jes/jpc1000/README.md

# JPC-1000

This is a repo containing Arduino code, KiCad files for PCBs, and FreeCAD files for the 3d-printed case.

Read more about the project on my blog: https://incoherency.co.uk/blog/stories/process-controller.html
