jes/jpc1000/case/mainboardholderclamp.obj

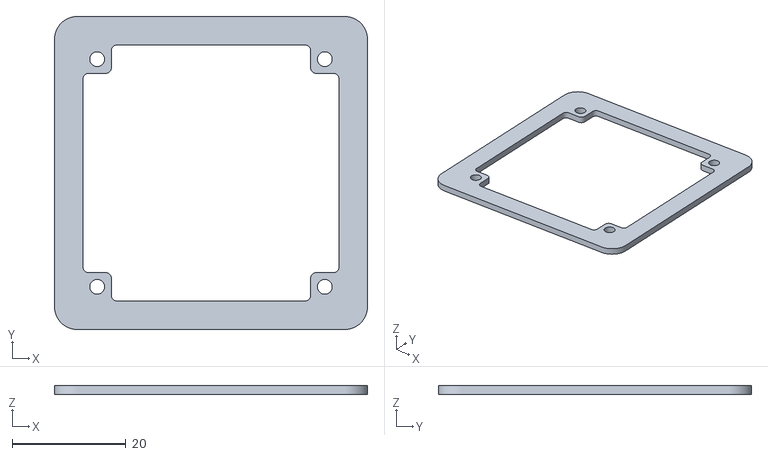
[picture p1: CAD file, 2019-08-26]
case/mainboardholderclamp.obj
55.0 x 55.0 x 1.50
