jes/jpc1000/case/mainboardholder.obj

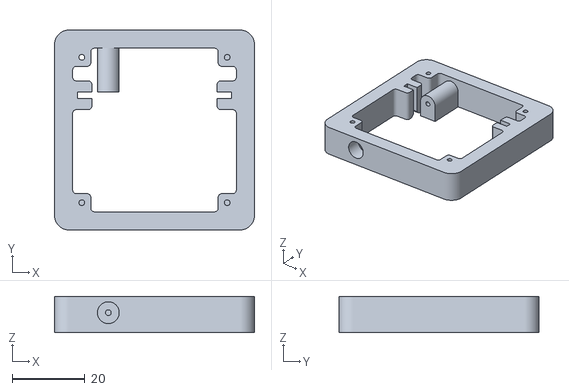
[picture p2: CAD file, 2019-08-26]
case/mainboardholder.obj
55.0 x 55.0 x 10.0
