jes/jpc1000/case/buttons.obj

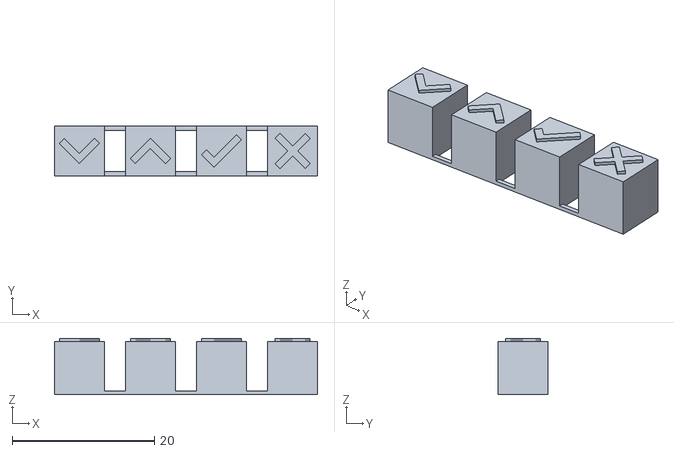
[picture p3: CAD file, 2019-09-01]
case/buttons.obj
37.0 x 7.00 x 7.90
