jes/jpc1000/case/frontcase.obj

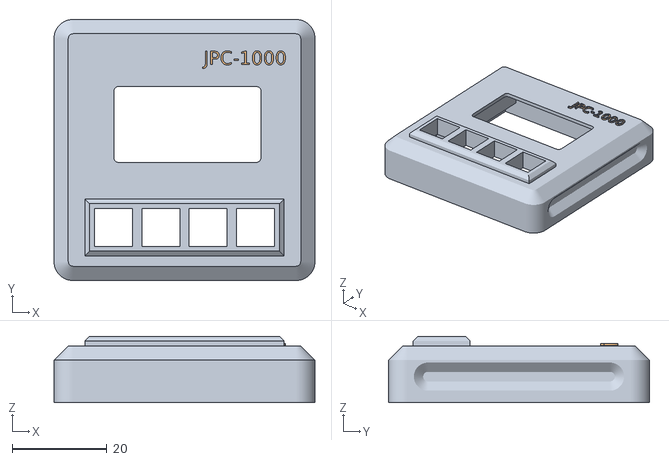
[picture p4: CAD file, 2019-09-01]
case/frontcase.obj
55.0 x 55.0 x 14.0
frontcase
