jes/jpc1000/case/jpc1000.fcstd

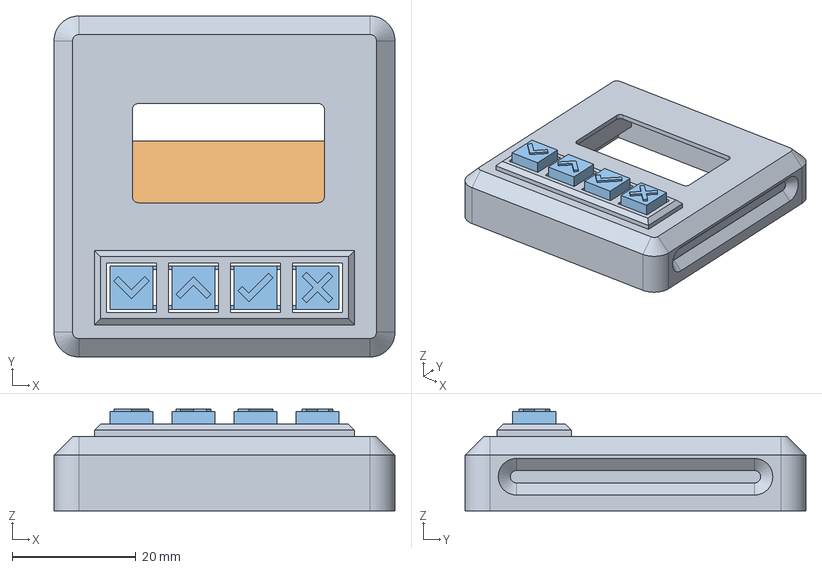
[picture p5: CAD file, 2019-09-01]
case/jpc1000.fcstd
55.0 x 55.0 x 16.4 mm
frontcase
frontpanelclamp
buttons
