jes/jpc1000/case/frontpanelclamp.obj

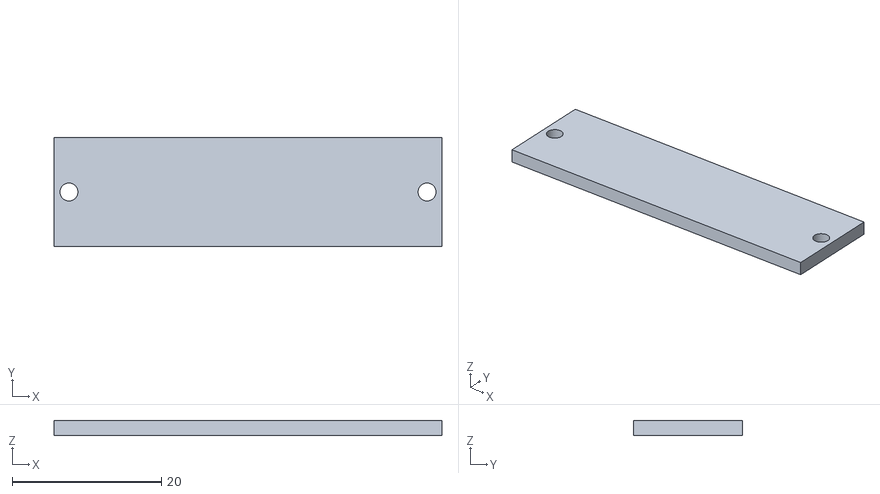
[picture p6: CAD file, 2019-09-01]
case/frontpanelclamp.obj
52.0 x 14.6 x 2.00
