jes/jpc1000/kicad/mainboard/mainboard.kicad_pcb

## KiCad design kicad/mainboard/mainboard.kicad_pcb (2019-08-26)

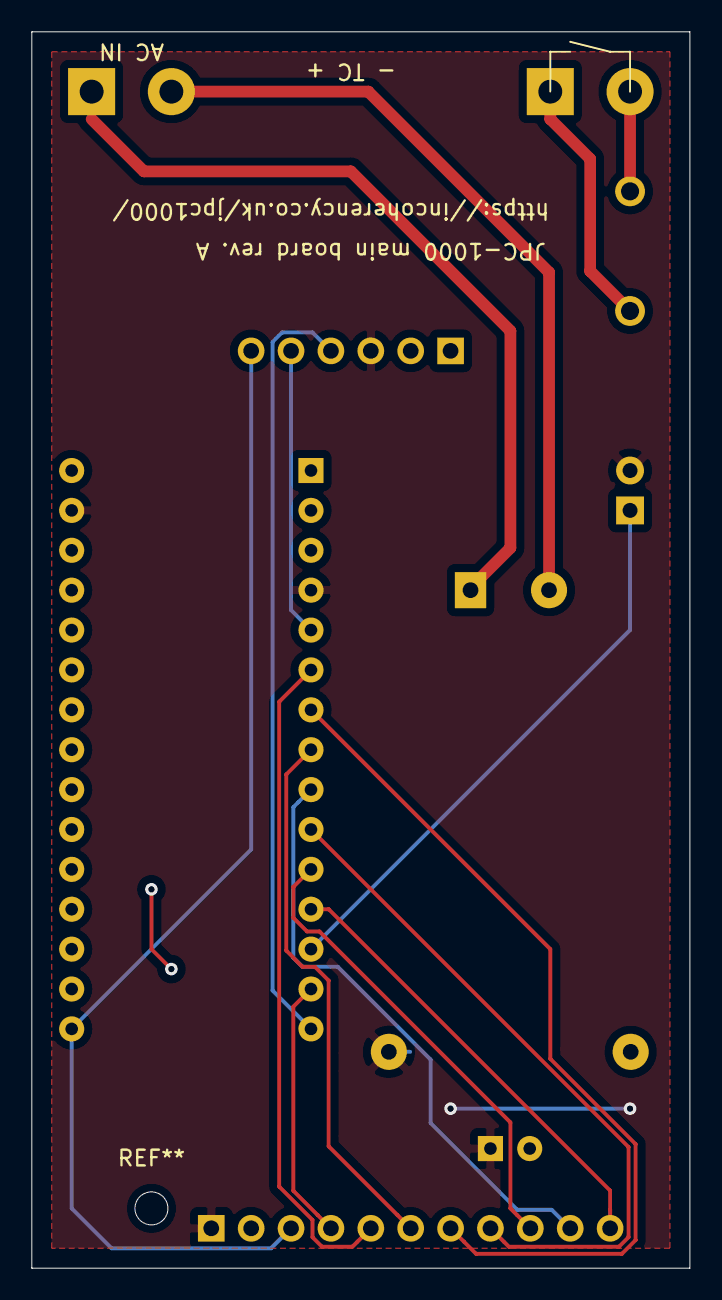
[picture p7: board mainboard.kicad_pcb from above]

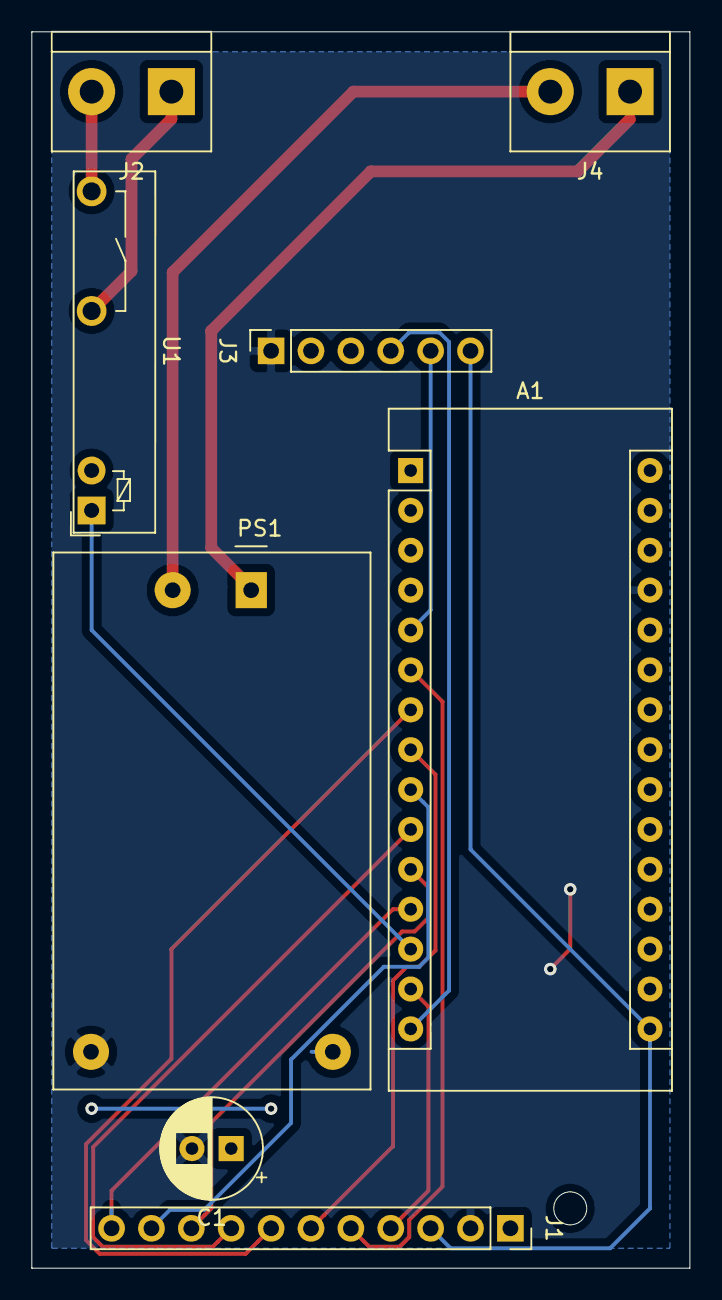
[picture p8: board mainboard.kicad_pcb from below]

Board: 2 copper layers, 41.9 x 78.7 mm, 8 parts (8 on the bottom side), 18 nets.

Parts:
A1: Arduino_Nano_v2.x; Arduino_Nano
C1: CP; CP_Radial_D6.3mm_P2.50mm
J1: Conn_01x11_Female; PinSocket_1x11_P2.54mm_Vertical
J2, J4: Screw_Terminal_01x02; TerminalBlock_bornier-2_P5.08mm
J3: Conn_01x06_Female; PinSocket_1x06_P2.54mm_Vertical
PS1: HLK-PM01; Converter_ACDC_HiLink_HLK-PMxx
U1: 34.81-8240; Omron-G3MB-202P

Connections:
unnamed: A1.5, J3.5
unnamed: A1.6, J1.5
unnamed: A1.7, J1.7
unnamed: A1.8, J1.6
unnamed: A1.9, J1.10
unnamed: A1.10, J1.8
unnamed: A1.11, J1.9
unnamed: A1.12, J1.11
unnamed: A1.13, U1.A2
unnamed: A1.14, J1.4
unnamed: A1.15, J3.4
unnamed: A1.16, J1.3, J3.6
unnamed: A1.27, C1.2, J1.2, J3.1, PS1.4
unnamed: A1.4, A1.29, C1.1, J1.1, J3.3, PS1.3, U1.A1
unnamed: J2.1, U1.11
unnamed: J2.2, U1.14
unnamed: J4.1, PS1.1
unnamed: J4.2, PS1.2
