jes/jpc1000/kicad/frontpanel/frontpanel.kicad_pcb

## KiCad design kicad/frontpanel/frontpanel.kicad_pcb (2019-08-19)

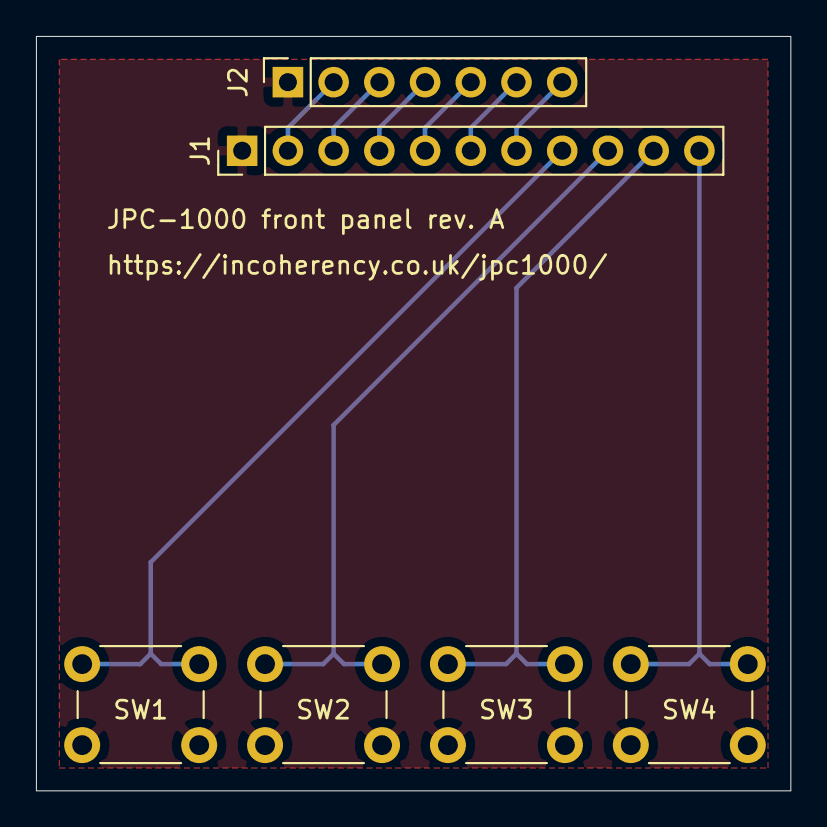
[picture p9: board frontpanel.kicad_pcb from above]

Board: 2 copper layers, 41.9 x 41.9 mm, 6 parts (0 on the bottom side), 11 nets.

Parts:
J1: Conn_01x11_Male; PinHeader_1x11_P2.54mm_Vertical
J2: Conn_01x07_Female; PinSocket_1x07_P2.54mm_Vertical
SW1, SW2, SW3, SW4: SW_Push; SW_PUSH_6mm_H4.3mm

Connections:
unnamed: J1.1, J2.1, SW1.2, SW2.2, SW3.2, SW4.2
unnamed: J1.2, J2.2
unnamed: J1.3, J2.3
unnamed: J1.4, J2.4
unnamed: J1.5, J2.5
unnamed: J1.6, J2.6
unnamed: J1.7, J2.7
unnamed: J1.8, SW1.1
unnamed: J1.9, SW2.1
unnamed: J1.10, SW3.1
unnamed: J1.11, SW4.1
