jes/jpc1000/(commit log)

2019-08-18 Add 'reset all' option, and switch heater on and off with duty cycle
    [jpc1000.ino]
2019-08-18 Format floats and times, add 'Save' button to segment editing menu
2019-08-18 Increase stepsize when button is held down
2019-08-18 Start of time editing, and make the Run button do something
2019-08-19 Set duty cycle manually, fix bugs
    [jpc1000.ino]
2019-08-19 For consistency, ramp first segment from initial setpoint instead of initial temperature
2019-08-19 Fix segment time display
    [jpc1000.ino]
2019-08-19 Add kicad project
    [frontpanel.kicad_pcb, frontpanel.sch, mainboard.kicad_pcb, mainboard.sch]
2019-08-20 Use MAX31855, fix PID
    [jpc1000.ino]
2019-08-20 Actually fix PID
2019-08-23 Never switch the heater more often than once per min_time
2019-08-26 Add CAD for case
    [jpc1000.fcstd, mainboardholder.obj, mainboardholderclamp.obj]
2019-08-26 Handle errors from the thermocouple reader
    [jpc1000.ino]
2019-08-26 Fix up a couple of errors on the mainboard PCB
    [mainboard.kicad_pcb]
2019-09-02 Explicitly set not-safe-to-operate if too long without a good temperature reading
    [jpc1000.ino]
